CXJ007/f1c200s/README.md

# f1c200s
做这个板子最初目的就是白嫖正点原子的教程，如果买板子按照我以前学习经历大多都是学习下外设那些的然后板子就吃灰了  
这个板子大部分都已经调通了（除了声音因为忘记买芯片后面过年又鸽了）  
还有值得注意的就是usbid 也就是pe2一不注意给占用了，板子上缺少按键学习的时候不太方便  

我是第一次画4层板，还是有很多不足的地方，用来学习应该没问题  
大致流程就是在社区帮助下移植好linux就可以白嫖了注意设备树添加是不一样的  
kicad6.0 ubuntu18 linux5.7.1  
最后附上社区地址https://whycan.com/
