CXJ007/f1c200s/fc200s/fc200s.pdf

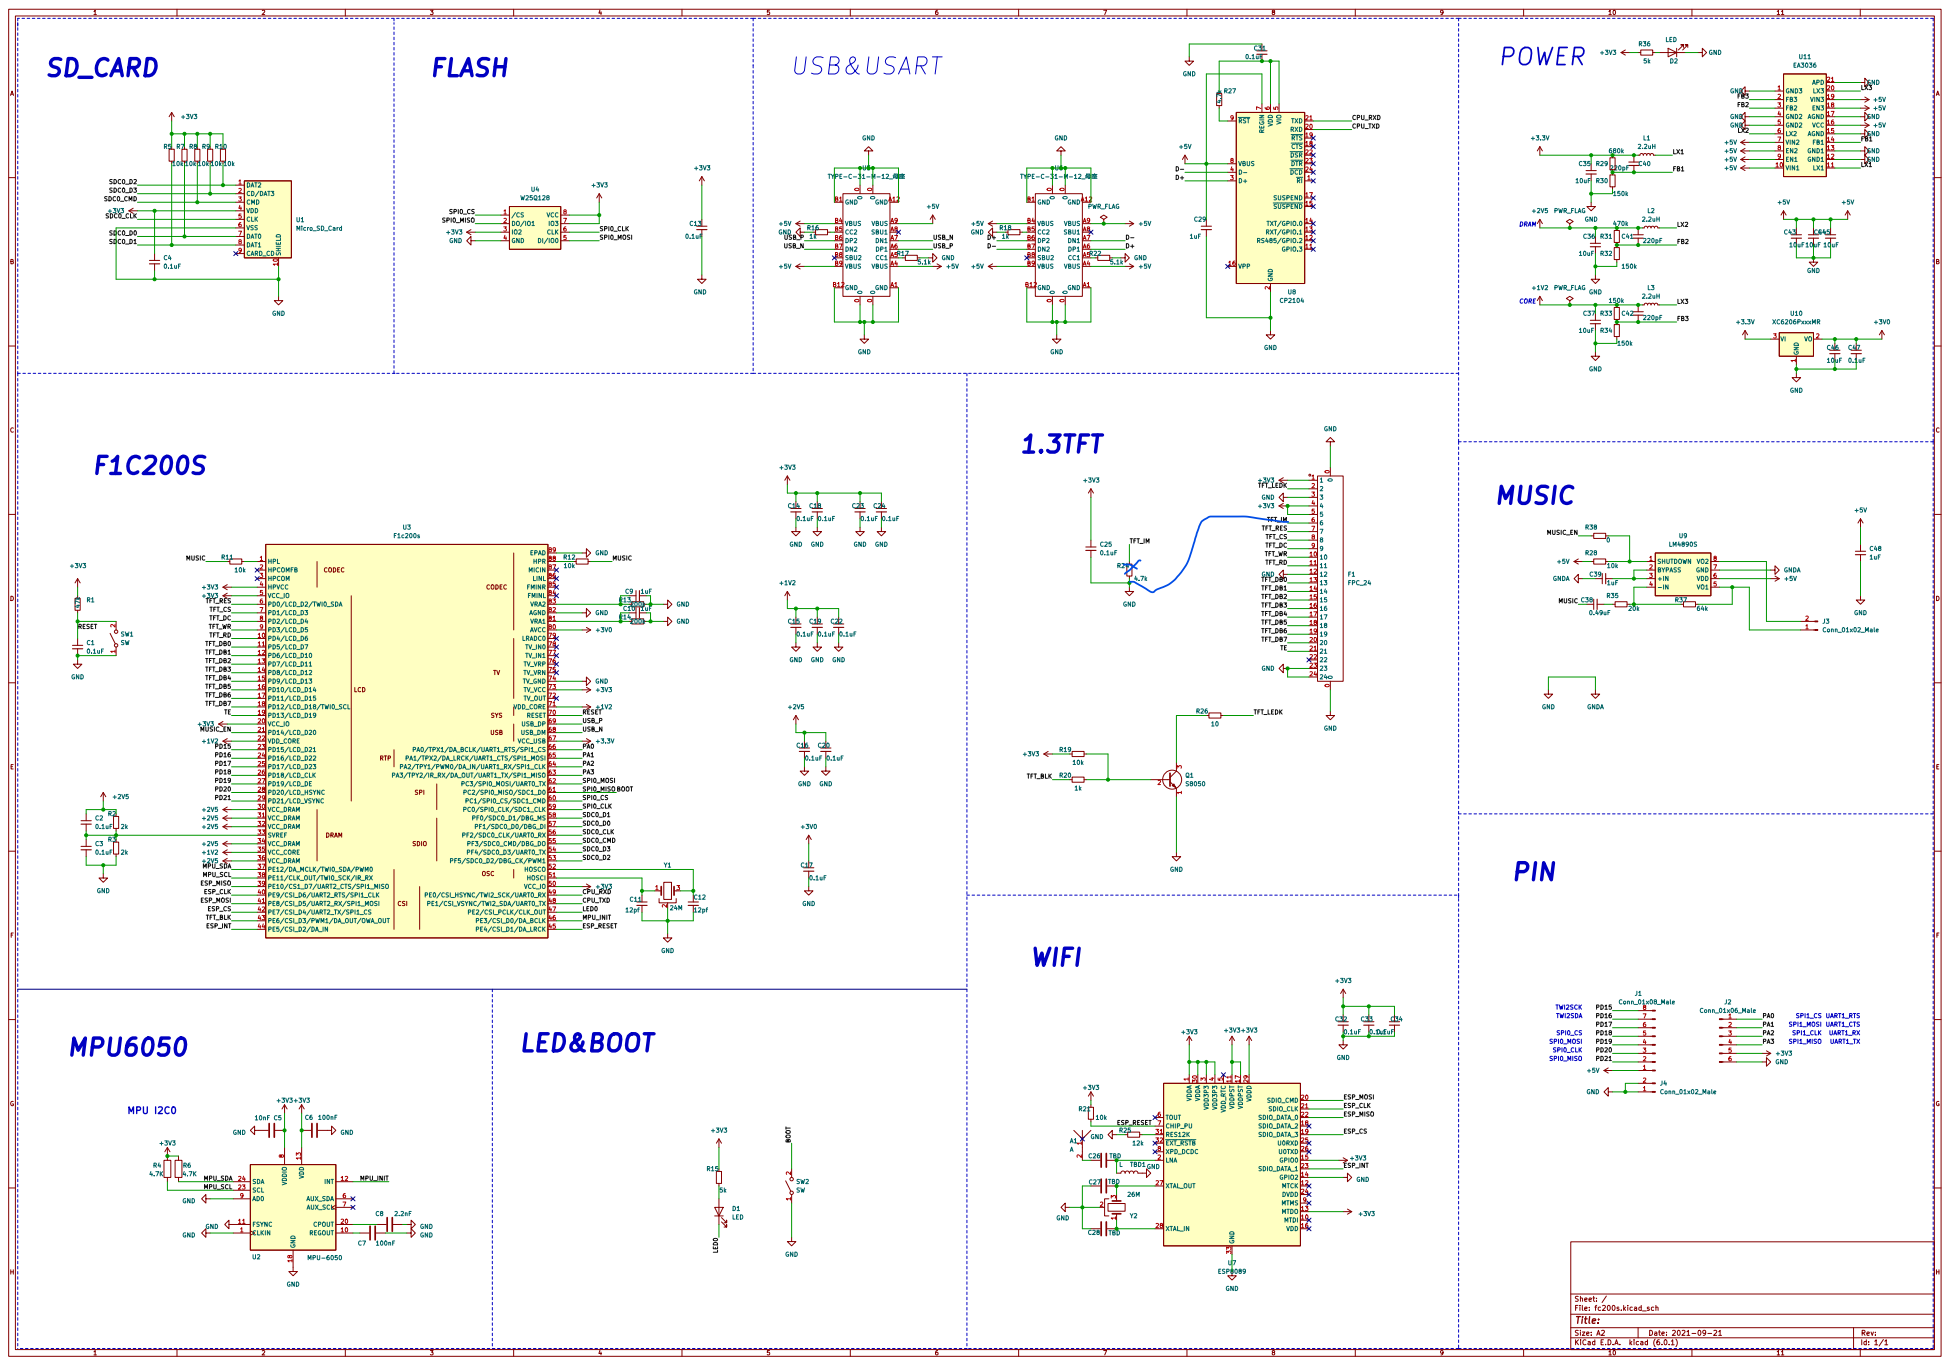
[picture p1: page 1]

0 GND A1 GNDA12 VBUS A4 CC1 A5 DP1 A6 DN1 A7 SBU1 A8 VBUS A9 GND B1 GND B12VBUS B4 CC2 B5 DP2 B6 DN2 B7 SBU2 B8 VBUS B9 U5

0 GND A1 GNDA12 VBUS A4 CC1 A5 DP1 A6 DN1 A7 SBU1 A8 VBUS A9 GND B1 GND B12VBUS B4 CC2 B5 DP2 B6 DN2 B7 SBU2 B8 VBUS B9 U6
