CXJ007/f1c200s/fc200s/fc200s.kicad_pcb

## KiCad design fc200s/fc200s.kicad_pcb (2022-02-02)

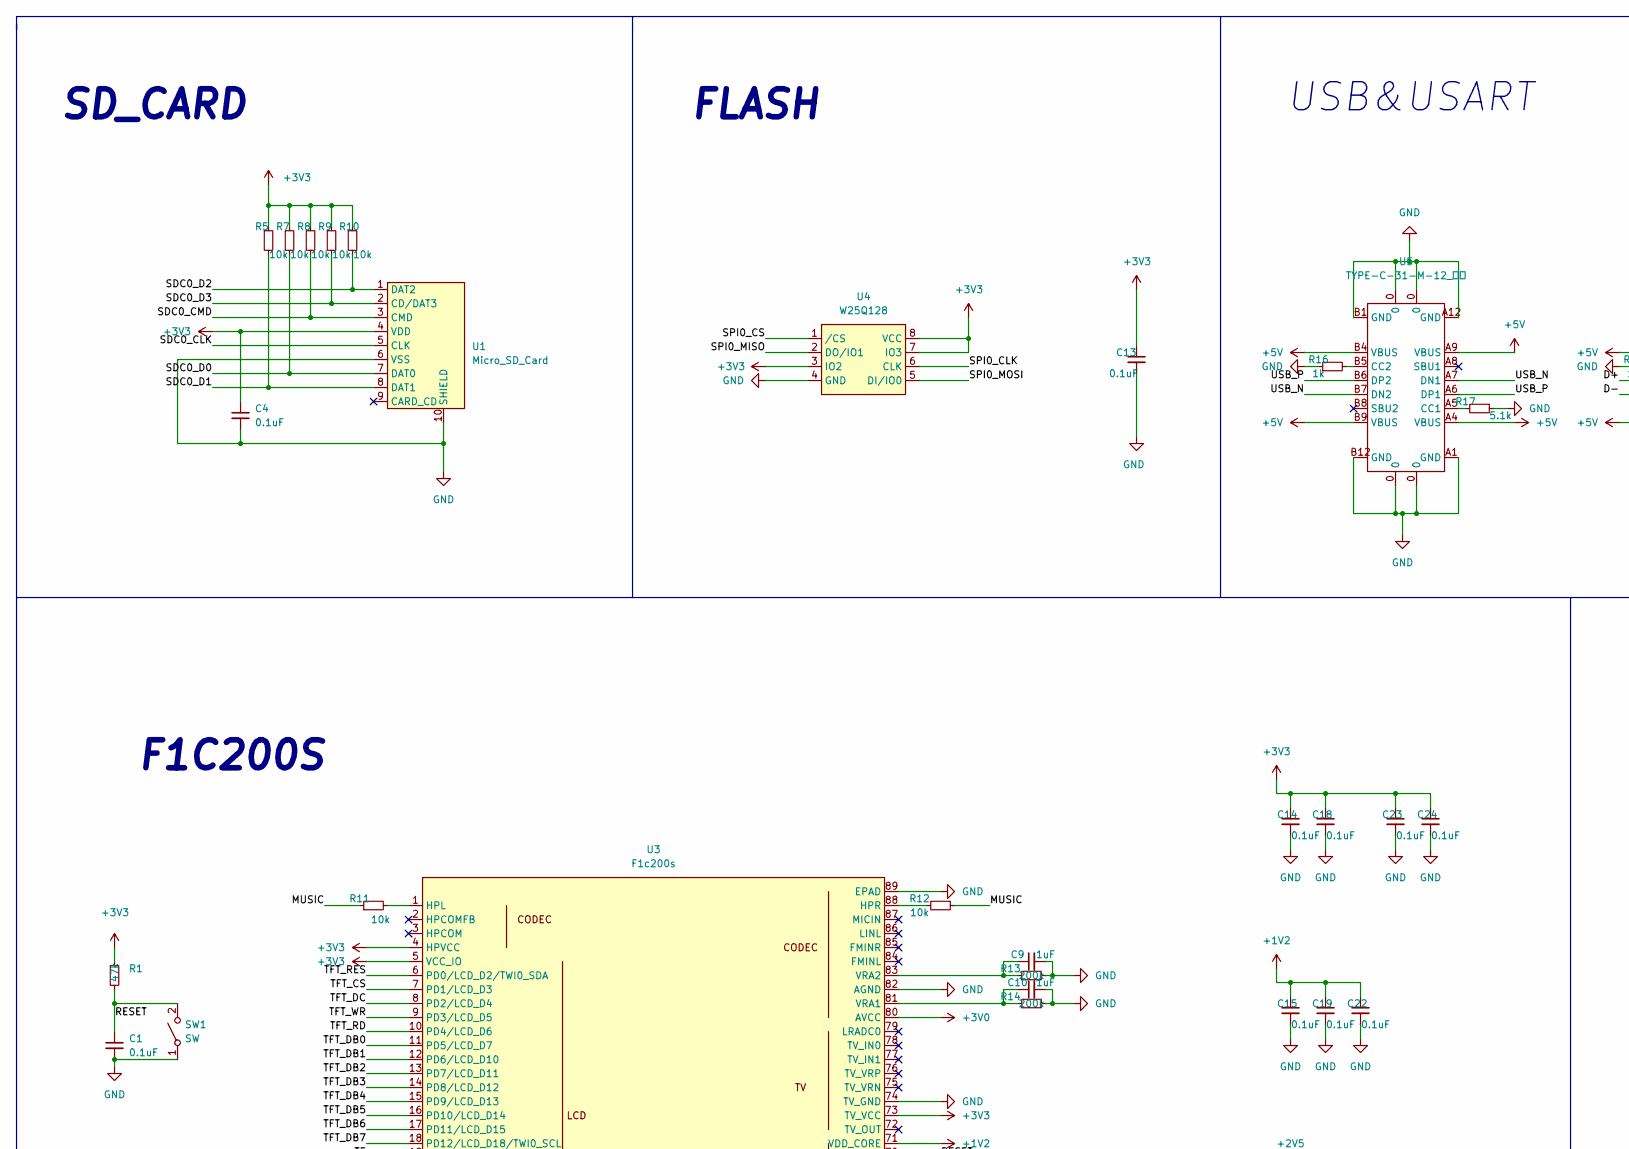
[picture p2: schematic fc200s.kicad_sch, part in row 1, column 1]

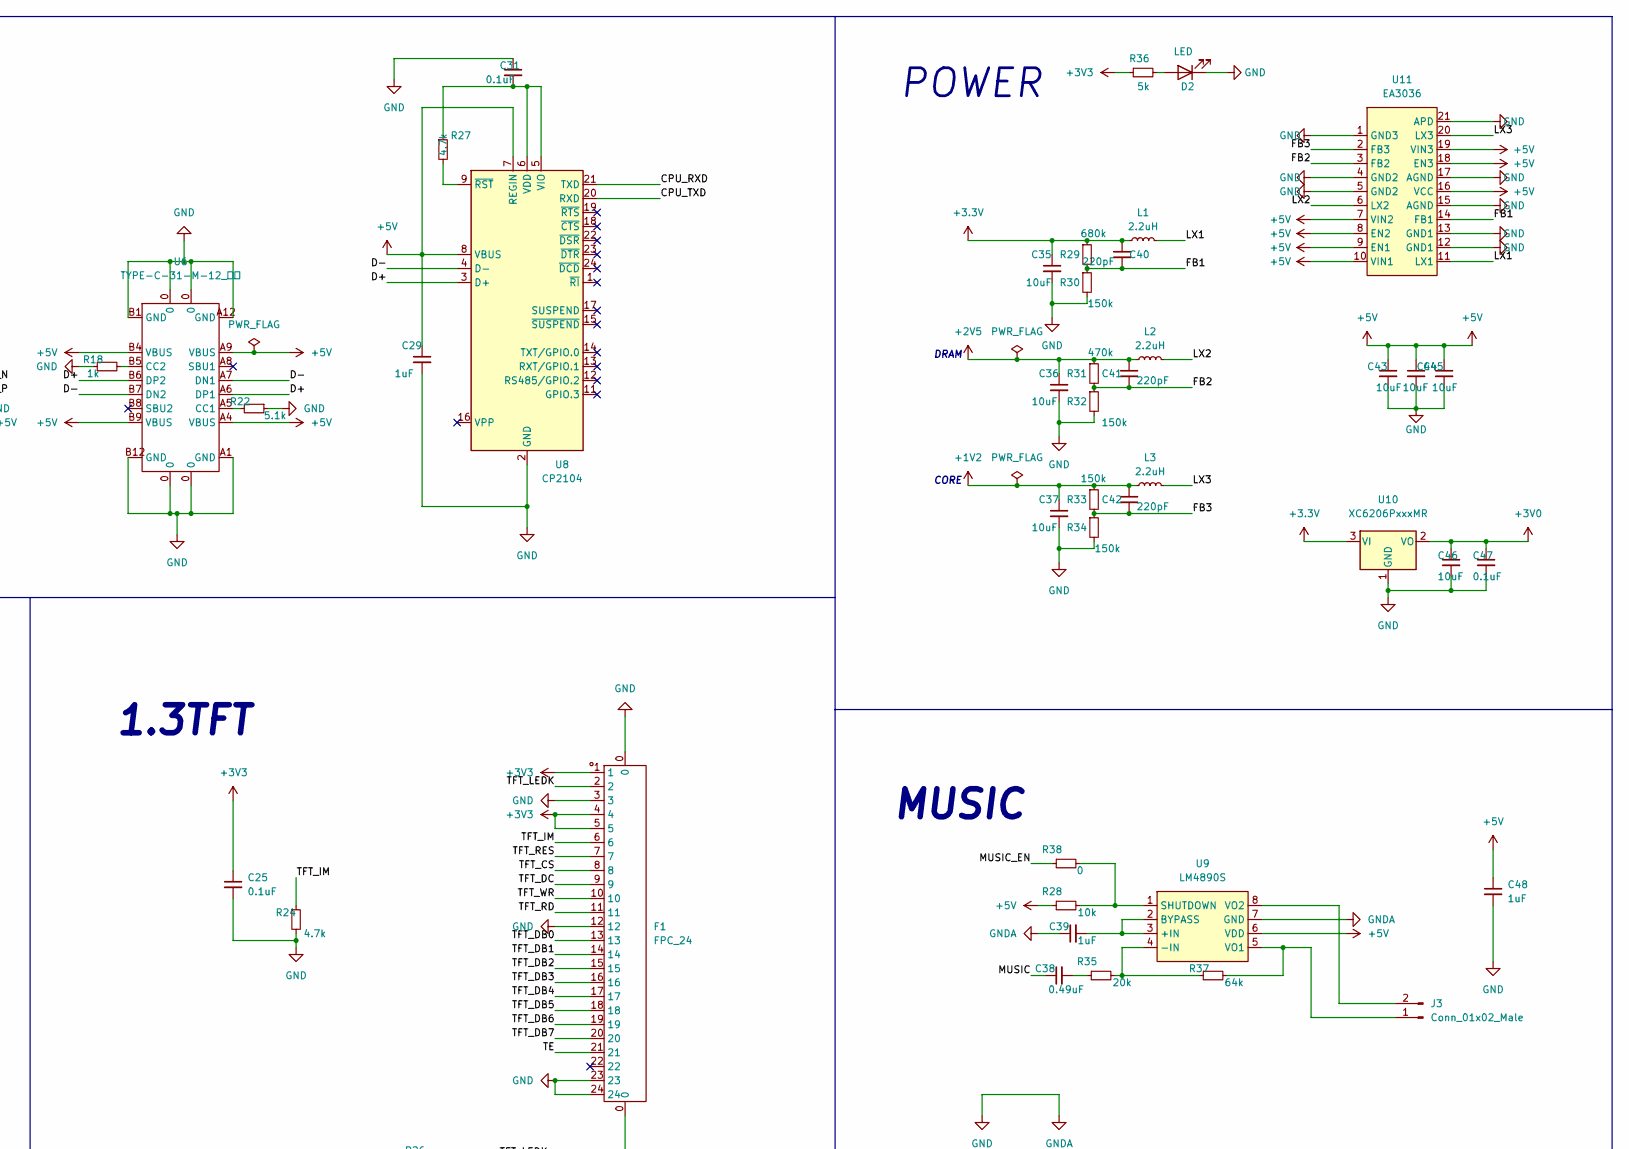
[picture p3: schematic fc200s.kicad_sch, part in row 1, column 2]

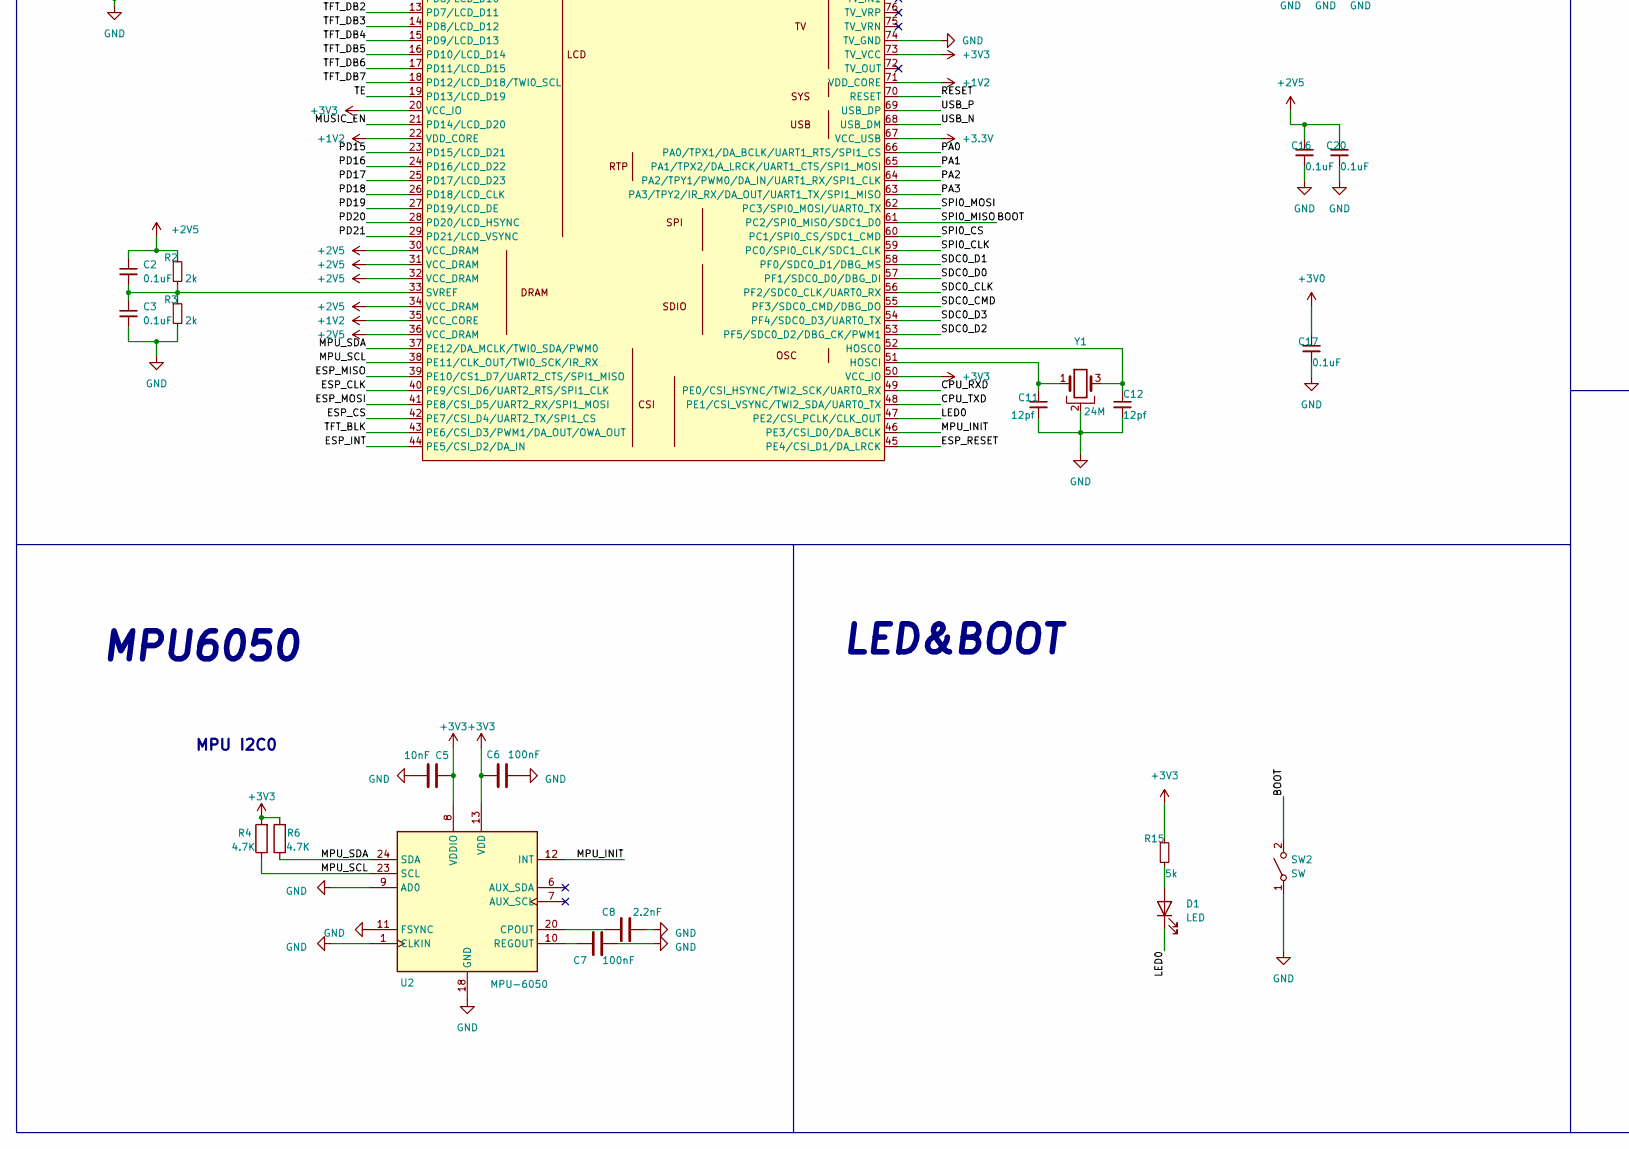
[picture p4: schematic fc200s.kicad_sch, part in row 2, column 1]

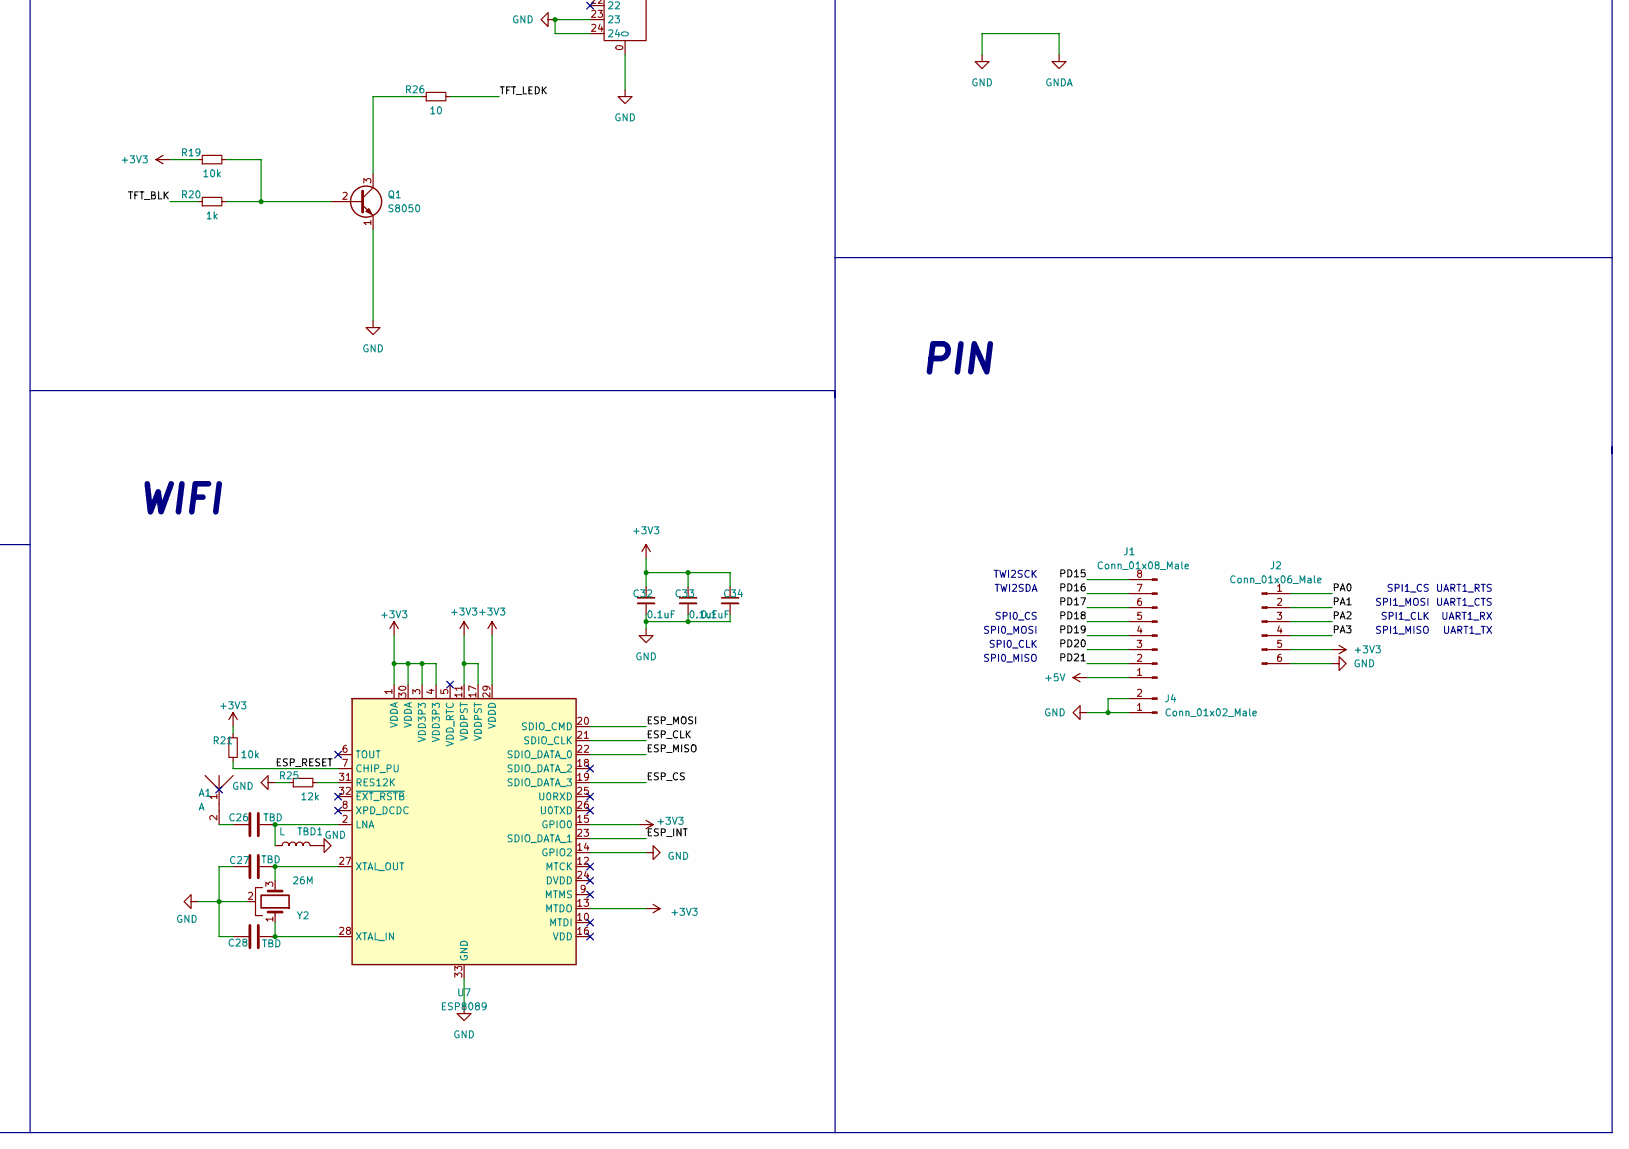
[picture p5: schematic fc200s.kicad_sch, part in row 2, column 2]

Parts:
A1: A; AN9520-245
C1, C2, C3, C4, C13, C14, C15, C16, C17, C18, C19, C20, C22, C23, C24, C25, C31, C32, C33, C34, C47: 0.1uF; C_0805_2012Metric
C5: 10nF; C_0805_2012Metric
C6, C7: 100nF; C_0805_2012Metric
C8: 2.2nF; C_0805_2012Metric
C9, C10, C29, C39, C48: 1uF; C_0805_2012Metric
C11, C12: 12pf; C_0805_2012Metric
C26, C27, C28: TBD; C_0805_2012Metric
C35, C36, C37, C43, C44, C45, C46: 10uF; C_0805_2012Metric
C38: 0.49uF; C_0805_2012Metric
C40, C41, C42: 220pF; C_0805_2012Metric
D1, D2: LED; LED_0805_2012Metric
F1: FPC_24; FPC_24_0.5
J1: Conn_01x08_Male; 8p_2.54
J2: Conn_01x06_Male; 6p_2.54
J3, J4: Conn_01x02_Male; 2p_2.54
L1, L2, L3: 2.2uH; L_0805_2012Metric
Q1: S8050; S8050_SOT_23
R1: 47k; R_0805_2012Metric
R2, R3: 2k; R_0805_2012Metric
R4, R6: 4.7K; R_0805_2012Metric
R5, R7, R8, R9, R10, R11, R12, R19, R21, R28: 10k; R_0805_2012Metric
R13, R14: 200k; R_0805_2012Metric
R15, R36: 5k; R_0805_2012Metric
R16, R18, R20: 1k; R_0805_2012Metric
R17, R22: 5.1k; R_0805_2012Metric
R24, R27: 4.7k; R_0805_2012Metric
R25: 12k; R_0805_2012Metric
R26: 10; R_0805_2012Metric
R29: 680k; R_0805_2012Metric
R30, R32, R33, R34: 150k; R_0805_2012Metric
R31: 470k; R_0805_2012Metric
R35: 20k; R_0805_2012Metric
R37: 64k; R_0805_2012Metric
R38: 0; R_0805_2012Metric
SW1, SW2: SW
TBD1: L; L_0805_2012Metric
U1: Micro_SD_Card; Micro_SD
U2: MPU-6050; InvenSense_QFN-24_4x4mm_P0.5mm
U3: F1c200s; QFN-88_EP_10x10_Pitch0.4mm
U4: W25Q128
U5, U6: TYPE-C-31-M-12_母座; typec 12
U7: ESP8089; QFN-32-1EP_5x5mm_P0.5mm_EP3.1x3.1mm_ThermalVias
U8: CP2104; QFN-24-1EP_4x4mm_P0.5mm_EP2.6x2.6mm
U9: LM4890S; LM4890S_MSOP_8
U10: XC6206PxxxMR; SOT-23
U11: EA3036; QFN-20-1EP_3x3mm_P0.4mm_EP1.65x1.65mm
Y1: 24M; X322512MSB4S
Y2: 26M; X322512MSB4S

Connections:
+1V2: C15.1, C19.1, C22.1, C37.1, C42.1, L3.1, R33.1, U3.22 (VDD_CORE), U3.35 (VCC_CORE), U3.71 (VDD_CORE)
+2V5: C2.1, C16.1, C20.1, C36.1, C41.1, L2.1, R2.1, R31.1, U3.30 (VCC_DRAM), U3.31 (VCC_DRAM), U3.32 (VCC_DRAM), U3.34 (VCC_DRAM), U3.36 (VCC_DRAM)
+3V0: C17.1, C46.1, C47.1, U3.80 (AVCC), U10.2 (VO)
+5V: C29.1, C43.1, C44.1, C45.1, C48.1, J1.1, R28.1, U5.A4 (VBUS), U5.A9 (VBUS), U5.B4 (VBUS), U5.B9 (VBUS), U6.A4 (VBUS), U6.A9 (VBUS), U6.B4 (VBUS), U6.B9 (VBUS), U8.7 (REGIN), U8.8 (VBUS), U9.6 (VDD), U11.7 (VIN2), U11.8 (EN2), U11.9 (EN1), U11.10 (VIN1), U11.16 (VCC), U11.18 (EN3), U11.19 (VIN3)
/BOOT: SW2.2 (B), U3.61 (PC2/SPI0_MISO/SDC1_D0), U4.2 (DO/IO1)
/CPU_RXD: U3.49 (PE0/CSI_HSYNC/TWI2_SCK/UART0_RX), U8.21 (TXD)
/CPU_TXD: U3.48 (PE1/CSI_VSYNC/TWI2_SDA/UART0_TX), U8.20 (RXD)
/D+: U6.A6 (DP1), U6.B6 (DP2), U8.3 (D+)
/D-: U6.A7 (DN1), U6.B7 (DN2), U8.4 (D-)
/ESP_CLK: U3.40 (PE9/CSI_D6/UART2_RTS/SPI1_CLK), U7.21 (SDIO_CLK)
/ESP_CS: U3.42 (PE7/CSI_D4/UART2_TX/SPI1_CS), U7.19 (SDIO_DATA_3)
/ESP_INT: U3.44 (PE5/CSI_D2/DA_IN), U7.23 (SDIO_DATA_1)
/ESP_MISO: U3.39 (PE10/CS1_D7/UART2_CTS/SPI1_MISO), U7.22 (SDIO_DATA_0)
/ESP_MOSI: U3.41 (PE8/CSI_D5/UART2_RX/SPI1_MOSI), U7.20 (SDIO_CMD)
/ESP_RESET: R21.2, U3.45 (PE4/CSI_D1/DA_LRCK), U7.7 (CHIP_PU)
/FB1: C40.2, R29.2, R30.1, U11.14 (FB1)
/FB2: C41.2, R31.2, R32.1, U11.3 (FB2)
/FB3: C42.2, R33.2, R34.1, U11.2 (FB3)
/LED0: D1.1 (K), U3.47 (PE2/CSI_PCLK/CLK_OUT)
/LX1: L1.2, U11.11 (LX1)
/LX2: L2.2, U11.6 (LX2)
/LX3: L3.2, U11.20 (LX3)
/MPU_INIT: U2.12 (INT), U3.46 (PE3/CSI_D0/DA_BCLK)
/MPU_SCL: R4.1, U2.23 (SCL), U3.38 (PE11/CLK_OUT/TWI0_SCK/IR_RX)
/MPU_SDA: R6.1, U2.24 (SDA), U3.37 (PE12/DA_MCLK/TWI0_SDA/PWM0)
/MUSIC: C38.1, R11.1, R12.1
/MUSIC_EN: R38.1, U3.21 (PD14/LCD_D20)
/PA0: J2.1, U3.66 (PA0/TPX1/DA_BCLK/UART1_RTS/SPI1_CS)
/PA1: J2.2, U3.65 (PA1/TPX2/DA_LRCK/UART1_CTS/SPI1_MOSI)
/PA2: J2.3, U3.64 (PA2/TPY1/PWM0/DA_IN/UART1_RX/SPI1_CLK)
/PA3: J2.4, U3.63 (PA3/TPY2/IR_RX/DA_OUT/UART1_TX/SPI1_MISO)
/PD15: J1.8, U3.23 (PD15/LCD_D21)
/PD16: J1.7, U3.24 (PD16/LCD_D22)
/PD17: J1.6, U3.25 (PD17/LCD_D23)
/PD18: J1.5, U3.26 (PD18/LCD_CLK)
/PD19: J1.4, U3.27 (PD19/LCD_DE)
/PD20: J1.3, U3.28 (PD20/LCD_HSYNC)
/PD21: J1.2, U3.29 (PD21/LCD_VSYNC)
/RESET: C1.1, R1.2, SW1.2 (B), U3.70 (RESET)
/SDC0_CLK: U1.5 (CLK), U3.56 (PF2/SDC0_CLK/UART0_RX)
/SDC0_CMD: R8.2, U1.3 (CMD), U3.55 (PF3/SDC0_CMD/DBG_DO)
/SDC0_D0: R7.2, U1.7 (DAT0), U3.57 (PF1/SDC0_D0/DBG_DI)
/SDC0_D1: R5.2, U1.8 (DAT1), U3.58 (PF0/SDC0_D1/DBG_MS)
/SDC0_D2: R10.2, U1.1 (DAT2), U3.53 (PF5/SDC0_D2/DBG_CK/PWM1)
/SDC0_D3: R9.2, U1.2 (CD/DAT3), U3.54 (PF4/SDC0_D3/UART0_TX)
/SPI0_CLK: U3.59 (PC0/SPI0_CLK/SDC1_CLK), U4.6 (CLK)
/SPI0_CS: U3.60 (PC1/SPI0_CS/SDC1_CMD), U4.1 (/CS)
/SPI0_MOSI: U3.62 (PC3/SPI0_MOSI/UART0_TX), U4.5 (DI/IO0)
/TE: F1.21, U3.19 (PD13/LCD_D19)
/TFT_BLK: R20.1, U3.43 (PE6/CSI_D3/PWM1/DA_OUT/OWA_OUT)
/TFT_CS: F1.8, U3.7 (PD1/LCD_D3)
/TFT_DB0: F1.13, U3.11 (PD5/LCD_D7)
/TFT_DB1: F1.14, U3.12 (PD6/LCD_D10)
/TFT_DB2: F1.15, U3.13 (PD7/LCD_D11)
/TFT_DB3: F1.16, U3.14 (PD8/LCD_D12)
/TFT_DB4: F1.17, U3.15 (PD9/LCD_D13)
/TFT_DB5: F1.18, U3.16 (PD10/LCD_D14)
/TFT_DB6: F1.19, U3.17 (PD11/LCD_D15)
/TFT_DB7: F1.20, U3.18 (PD12/LCD_D18/TWI0_SCL)
/TFT_DC: F1.9, U3.8 (PD2/LCD_D4)
/TFT_IM: F1.6, R24.1
/TFT_LEDK: F1.2, R26.2
/TFT_RD: F1.11, U3.10 (PD4/LCD_D6)
/TFT_RES: F1.7, U3.6 (PD0/LCD_D2/TWI0_SDA)
/TFT_WR: F1.10, U3.9 (PD3/LCD_D5)
/USB_N: U3.68 (USB_DM), U5.A7 (DN1), U5.B7 (DN2)
/USB_P: U3.69 (USB_DP), U5.A6 (DP1), U5.B6 (DP2)
GND: C1.2, C3.2, C4.2, C5.2, C6.2, C7.2, C8.2, C9.2, C10.2, C11.2, C12.2, C13.2, C14.2, C15.2, C16.2, C17.2, C18.2, C19.2, C20.2, C22.2, C23.2, C24.2, C25.2, C27.1, C28.1, C29.2, C31.1, C32.2, C33.2, C34.2, C35.2, C36.2, C37.2, C39.1, C43.2, C44.2, C45.2, C46.2, C47.2, C48.2, D2.1 (K), F1.0, F1.3, F1.12, F1.23, F1.24, J2.6, J4.1, J4.2, Q1.1 (E), R3.2, R13.2, R14.2, R16.1, R17.1, R18.1, R22.1, R24.2, R25.1, R30.2, R32.2, R34.2, SW1.1 (A), SW2.1 (A), TBD1.2, U1.6 (VSS), U1.10 (SHIELD), U2.1 (CLKIN), U2.9 (AD0), U2.11 (FSYNC), U2.18 (GND), U3.74 (TV_GND), U3.82 (AGND), U3.89 (EPAD), U4.4 (GND), U5.0, U5.A1 (GND), U5.A12 (GND), U5.B1 (GND), U5.B12 (GND), U6.0, U6.A1 (GND), U6.A12 (GND), U6.B1 (GND), U6.B12 (GND), U7.14 (GPIO2), U7.33 (GND), U8.2 (GND), U8.25 (GND), U9.7 (GND), U10.1 (GND), U11.1 (GND3), U11.4 (GND2), U11.5 (GND2), U11.12 (GND1), U11.13 (GND1), U11.15 (AGND), U11.17 (AGND), U11.21 (APD), Y1.2, Y2.2
unnamed: A1.2, C26.1
unnamed: C2.2, C3.1, R2.2, R3.1, U3.33 (SVREF)
unnamed: C7.1, U2.10 (REGOUT)
unnamed: C8.1, U2.20 (CPOUT)
unnamed: C9.1, R13.1, U3.83 (VRA2)
unnamed: C10.1, R14.1, U3.81 (VRA1)
unnamed: C11.1, U3.51 (HOSCI), Y1.1
unnamed: C12.1, U3.52 (HOSCO), Y1.3
unnamed: C26.2, TBD1.1, U7.2 (LNA)
unnamed: C27.2, U7.27 (XTAL_OUT), Y2.3
unnamed: C28.2, U7.28 (XTAL_IN), Y2.1
unnamed: C31.2, R27.1, U8.5 (VIO), U8.6 (VDD)
unnamed: C38.2, R35.1
unnamed: C39.2, U9.2 (BYPASS), U9.3 (+IN)
unnamed: D1.2 (A), R15.2
unnamed: D2.2 (A), R36.2
unnamed: J3.1, R37.2, U9.5 (VO1)
unnamed: J3.2, U9.8 (VO2)
unnamed: Q1.2 (B), R19.2, R20.2
unnamed: Q1.3 (C), R26.1
unnamed: R11.2, U3.1 (HPL)
unnamed: R12.2, U3.88 (HPR)
unnamed: R16.2, U5.B5 (CC2)
unnamed: R17.2, U5.A5 (CC1)
unnamed: R18.2, U6.B5 (CC2)
unnamed: R22.2, U6.A5 (CC1)
unnamed: R25.2, U7.31 (RES12K)
unnamed: R27.2, U8.9 (~RST)
unnamed: R28.2, R38.2, U9.1 (SHUTDOWN)
unnamed: R35.2, R37.1, U9.4 (-IN)

Notes on the sheet:
LED&BOOT
POWER
PIN
USB&USART
UART1_TX
MPU I2C0
MUSIC
FLASH
WIFI
UART1_CTS
SPI1_MISO
CORE
SPI0_CLK
DRAM
TWI2SDA
F1C200S
UART1_RTS
SPI1_CS
SPI1_MOSI
SPI1_CLK
SPI0_CS
SPI0_MISO
MPU6050
SD_CARD
SPI0_MOSI
UART1_RX
TWI2SCK
1.3TFT

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
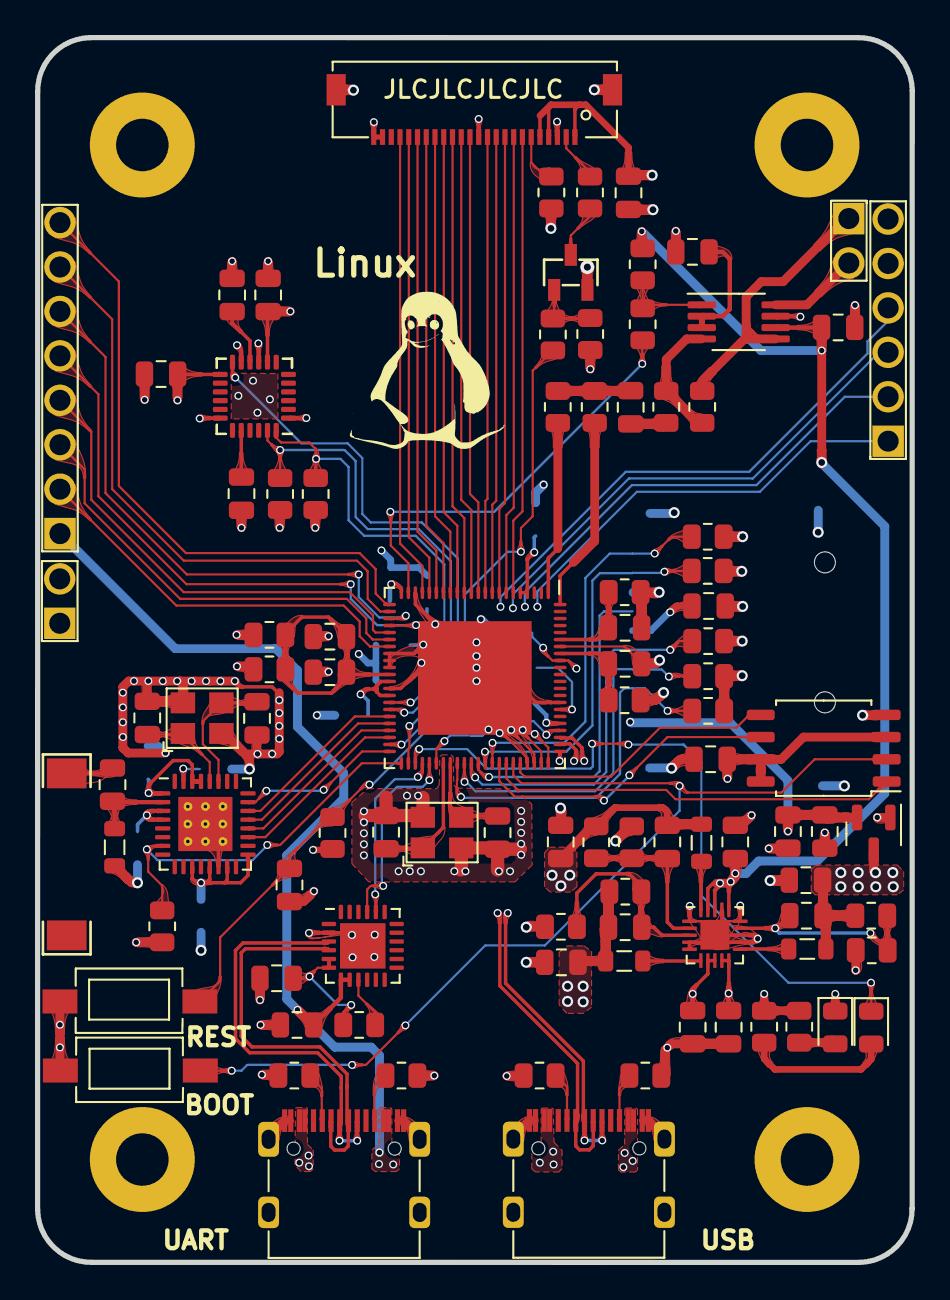
[picture p6: board fc200s.kicad_pcb from above]

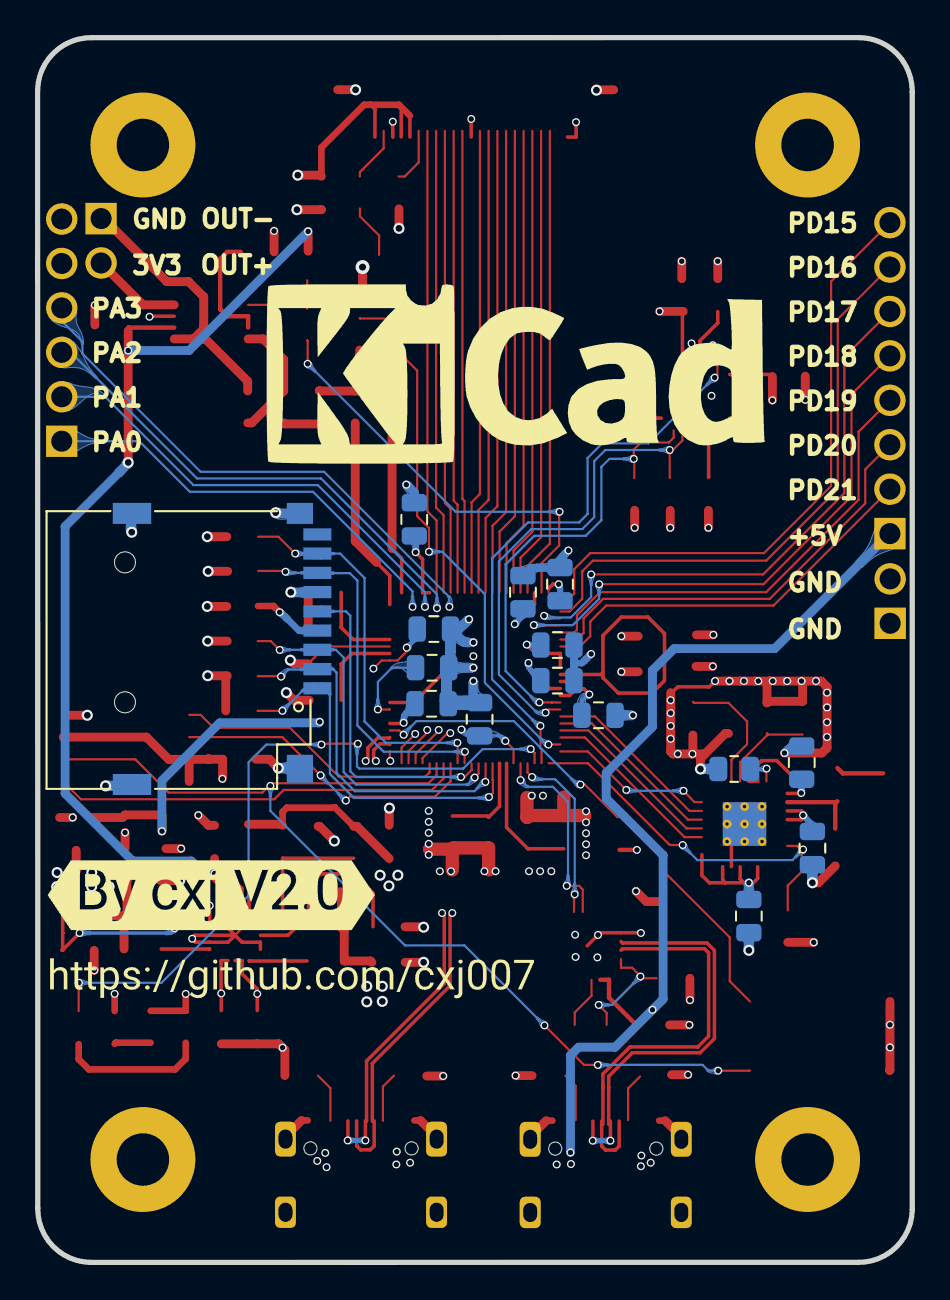
[picture p7: board fc200s.kicad_pcb from below]

Board: 4 copper layers, 50.0 x 70.0 mm, 113 parts (17 on the bottom side), 99 nets.

Other parts of the board:
kibuzzard-616427ED: G***; kibuzzard-616427ED
kibuzzard-61642942: G***; kibuzzard-61642942
