CXJ007/f1c200s/linux/suniv-f1c100s.dtsi

// SPDX-License-Identifier: (GPL-2.0+ OR X11)
/*
 * Copyright 2018 Icenowy Zheng <icenowy@aosc.io>
 * Copyright 2018 Mesih Kilinc <mesihkilinc@gmail.com>
 */

#include <dt-bindings/clock/suniv-ccu-f1c100s.h>
#include <dt-bindings/reset/suniv-ccu-f1c100s.h>
#include <dt-bindings/interrupt-controller/irq.h>
#include <dt-bindings/gpio/gpio.h>
#include <dt-bindings/leds/common.h>

/ {
	#address-cells = <1>;
	#size-cells = <1>;
	interrupt-parent = <&intc>;

	clocks {
		osc24M: clk-24M {
			#clock-cells = <0>;
			compatible = "fixed-clock";
			clock-frequency = <24000000>;
			clock-output-names = "osc24M";
		};

		osc32k: clk-32k {
			#clock-cells = <0>;
			compatible = "fixed-clock";
			clock-frequency = <32768>;
			clock-output-names = "osc32k";
		};
	};

	cpus {
		cpu {
			compatible = "arm,arm926ej-s";
			device_type = "cpu";
		};
	};

	soc {
		compatible = "simple-bus";
		#address-cells = <1>;
		#size-cells = <1>;
		ranges;

		sram-controller@1c00000 {
			compatible = "allwinner,suniv-f1c100s-system-control",
				     "allwinner,sun4i-a10-system-control";
			reg = <0x01c00000 0x30>;
			#address-cells = <1>;
			#size-cells = <1>;
			ranges;

			sram_d: sram@10000 {
				compatible = "mmio-sram";
				reg = <0x00010000 0x1000>;
				#address-cells = <1>;
				#size-cells = <1>;
				ranges = <0 0x00010000 0x1000>;

				otg_sram: sram-section@0 {
					compatible = "allwinner,suniv-f1c100s-sram-d",
						     "allwinner,sun4i-a10-sram-d";
					reg = <0x0000 0x1000>;
					status = "disabled";
				};
			};
		};

		ccu: clock@1c20000 {
			compatible = "allwinner,suniv-f1c100s-ccu";
			reg = <0x01c20000 0x400>;
			clocks = <&osc24M>, <&osc32k>;
			clock-names = "hosc", "losc";
			#clock-cells = <1>;
			#reset-cells = <1>;
		};

		intc: interrupt-controller@1c20400 {
			compatible = "allwinner,suniv-f1c100s-ic";
			reg = <0x01c20400 0x400>;
			interrupt-controller;
			#interrupt-cells = <1>;
		};

		pio: pinctrl@1c20800 {
			compatible = "allwinner,suniv-f1c100s-pinctrl";
			reg = <0x01c20800 0x400>;
			interrupts = <38>, <39>, <40>;
			clocks = <&ccu 37>, <&osc24M>, <&osc32k>;
			clock-names = "apb", "hosc", "losc";
			gpio-controller;
			interrupt-controller;
			#interrupt-cells = <3>;
			#gpio-cells = <3>;

			uart0_pe_pins: uart0-pe-pins {
				pins = "PE0", "PE1";
				function = "uart0";
			};

			mmc0_pins: mmc0-pins {
                pins = "PF0", "PF1", "PF2", "PF3", "PF4", "PF5";
                function = "mmc0";
            };

			i2c0_pe_pins: i2c0-pe-pins {
				pins = "PE11", "PE12";
				function = "i2c0";
			};

			spi0_pd_pins: spi0-pd-pins {
                pins = "PD20","PD18","PD21","PD19";
                function = "spi0";
            };

			spi1_pe_pins: spi1-pe-pins {
                pins = "PE9","PE7","PE10","PE8";
                function = "spi1";
            };

			led_pins: led-pins {
                pins = "PE2";
                function = "led";
            };

			key_pins: key-pins {
                pins = "PD15";
                function = "key";
            };

			// irq_pins: irq_pins {
            //     pins = "PD16";
            //     function = "irq";
            // };

			tft_pins: tft-pins {
                pins = "PD15","PD16","PD17";
                function = "tft";
            };

			tft8_pins: tft8-pins {
				pins = "PD0","PD1","PD2","PD3","PD4","PD5","PD6","PD7",
					"PD8","PD9","PD10","PD11","PD12","PD13";
				function = "ftf8080";
			};

		};

		timer@1c20c00 {
			compatible = "allwinner,suniv-f1c100s-timer";
			reg = <0x01c20c00 0x90>;
			interrupts = <13>;
			clocks = <&osc24M>;
		};

		mmc0: mmc@1c0f000 {
			compatible = "allwinner,suniv-f1c100s-mmc",
				     "allwinner,sun7i-a20-mmc";
			reg = <0x01c0f000 0x1000>;
			clocks = <&ccu CLK_BUS_MMC0>,
				 <&ccu CLK_MMC0>,
				 <&ccu CLK_MMC0_OUTPUT>,
				 <&ccu CLK_MMC0_SAMPLE>;
			clock-names = "ahb",
				      "mmc",
				      "output",
				      "sample";
			resets = <&ccu RST_BUS_MMC0>;
			reset-names = "ahb";
			interrupts = <23>;
			pinctrl-names = "default";
			pinctrl-0 = <&mmc0_pins>;
			status = "disabled";
			#address-cells = <1>;
			#size-cells = <0>;
		};

		wdt: watchdog@1c20ca0 {
			compatible = "allwinner,suniv-f1c100s-wdt",
				     "allwinner,sun4i-a10-wdt";
			reg = <0x01c20ca0 0x20>;
		};

		uart0: serial@1c25000 {
			compatible = "snps,dw-apb-uart";
			reg = <0x01c25000 0x400>;
			interrupts = <1>;
			reg-shift = <2>;
			reg-io-width = <4>;
			clocks = <&ccu 38>;
			resets = <&ccu 24>;
			status = "disabled";
		};

		uart1: serial@1c25400 {
			compatible = "snps,dw-apb-uart";
			reg = <0x01c25400 0x400>;
			interrupts = <2>;
			reg-shift = <2>;
			reg-io-width = <4>;
			clocks = <&ccu 39>;
			resets = <&ccu 25>;
			status = "disabled";
		};

		uart2: serial@1c25800 {
			compatible = "snps,dw-apb-uart";
			reg = <0x01c25800 0x400>;
			interrupts = <3>;
			reg-shift = <2>;
			reg-io-width = <4>;
			clocks = <&ccu 40>;
			resets = <&ccu 26>;
			status = "disabled";
		};

		i2c0: i2c@1c27000 {
			compatible = "allwinner,sun6i-a31-i2c";
			reg = <0x01c27000 0x400>;
			interrupts = <7>;
			clocks = <&ccu CLK_BUS_I2C0>;
			resets = <&ccu RST_BUS_I2C0>;
			pinctrl-names = "default";
			pinctrl-0 = <&i2c0_pe_pins>;
			status = "disabled";
			#address-cells = <1>;
			#size-cells = <0>;
		};

		spi0: spi@1c05000 {
            compatible = "allwinner,suniv-spi",
                     "allwinner,sun8i-h3-spi";
            reg = <0x01c05000 0x1000>;
            interrupts = <10>;
            clocks = <&ccu CLK_BUS_SPI0>, <&ccu CLK_BUS_SPI0>;
            clock-names = "ahb", "mod";
            resets = <&ccu RST_BUS_SPI0>;
            status = "disabled";
            #address-cells = <1>;
            #size-cells = <0>;
        };

		spi1: spi@1c06000 {
			compatible = "allwinner,suniv-f1c100s-spi",
					 "allwinner,sun8i-h3-spi";
			reg = <0x01c06000 0x1000>;
			interrupts = <11>;
			clocks = <&ccu CLK_BUS_SPI1>, <&ccu CLK_BUS_SPI1>;
			clock-names = "ahb", "mod";
			resets = <&ccu RST_BUS_SPI1>;
			status = "disabled";
			#address-cells = <1>;
			#size-cells = <0>;
		};
	};
};
